brainstewdev/ir-tracker/descrizione.md

IR tracker

Autore: Lorenzo Lucca

Descrizione:
il progetto mira alla creazione di un sistema che permetta ad una webcam/microfono di tracciare un oggetto, montandolo sopra ad una base girevole.
per riuscere in questo sono stati utilizzati sensori ed emettitori infrarossi in modo tale che non sia di disturbo per l'ambiente non essendo visibili. 
l'hardware coinvolto è:

- arduino uno
- servomotore
- 6 fototransistor IR
- 1 LED IR
- alimentatore e regolatore di tensione

per la parte software invece si basa sul trovare il sensore con la minima lettura (quello quindi che punta maggiormente verso la sorgente) e girare la base verso quel sensore, in modo da centrarlo.

Link a repo: https://github.com/brainstewdev/ir-tracker

Licenza scelta: GNU General Public License v3

Data *indicativa* di presentazione: novembre 2024
