brainstewdev/ir-tracker/ir-tracker/ir-tracker.ino

#include<Servo.h>

#define SERVO_PIN 3


/*
    documentazione generale

    per collgare i phototransistor si va a collegare il catodo con il - e l'anodo al + con 
    un a resistenza di 10kohm

    all'interno dell'array pins verrano inseriti i pin a cui sono collegati i phototransistor, 
    da sinistra verso destra.

    all'inizio il servo sarà centrato, saranno impostati i pin in input e poi inizializza la comunicazione seriale
*/

  
Servo servo;

int pos = 90; // posizione del servo, di partenza centrata

int pinS[] = {A0, A1, A2, A3, A4, A5};

int lett[] = {0, 0, 0,0,0, 0};

void setup(){
    /*
        - imposta i pin
        - imposta il servo
        - inizializza serial per debug
    */
    for(int i = 0; i < 6; i++){
        pinMode(pinS[i], INPUT);
    }

   servo.attach(SERVO_PIN);
   servo.write(pos);

   Serial.begin(9600);
}

void loop(){
    // legge i valori dei sensori
     for(int i = 0; i < 6; i++){
        lett[i] = analogRead(pinS[i]);
        
        Serial.print("{");
        Serial.print(i);
        Serial.print(":");
        Serial.print(lett[i]);
        Serial.print("}");
        
    }
    int off = calcolaOffset(lett[0], lett[1], lett[2], lett[3], lett[4], lett[5]);
    servo.write(pos + off);   
    pos = servo.read();
    delay(15);
}

/*
    funzione che date le letture dei sensori calcola l'offset
*/
int calcolaOffset(int x1, int x2, int x3, int x4, int x5, int x6){
    // dove sto puntando sarà il minimo: mi sposto verso chi ha una lettura minore
    int arrLetture[] = {x1,x2,x3,x4,x5,x6};
    int sensMin = posMin(arrLetture, 6);
    // se esiste un sensore con lettura minima
    if(sensMin > -1){
    // se la differenza tra le letture è maggiore della soglia allora:
      if(diffMax(arrLetture,6) > 200){
        // restituisi un offset che varia da 10 a -10
        return map(sensMin, 0, 5, 10,-10);
      }
    }
    // restituisci un offset nullo (sta fermo)
    return 0;
}
// restituisce la massima differenza tra un sensore e uno adiacente
int diffMax(int *arr, int dim){
  int max = -1;
  int diffSx,diffDx;
  for(int i = 1; i < dim-1; i++){
    diffSx = (arr[i-1]-arr[i])*(arr[i-1]-arr[i]);
    diffDx = (arr[i]-arr[i+1])*(arr[i]-arr[i+1]);
    if(diffSx > max){
      max = diffSx;
    }else if(diffDx > max){
      max = diffDx;
    }
  }
  return max;
}
// funzione che dato un array ne calcola la posizione contenente il valore minore
int posMin(int *arr, int dim){
  int min = 1023;
  int pos = -1;
  for(int i = 0; i < dim; i++){
    if(arr[i] < min){
      min = arr[i];
      pos = i;
    }
  }
  return pos;
}
/*
    funzione che data una posizione (globale) e un offset restituisce il valore che:
        - è posizione + offset se <= 180 e >= 0
        - 180 se posizione + offset > 180
        - 0 se posizione + offset < 0
*/
int ottieniPos(int offset){
    if(pos + offset < 0){
        return 0;
    }else if(pos + offset > 180){
        return 180;
    }
    return pos + offset;
}
