brainstewdev/ir-tracker/(commit log)

2024-03-03 funziona di base ma problemi
    infatti va tutto a sinistra se non riceve alcun segnale invece di stare
    fermo oppure fare "radar". inoltre una volta che centra più o meno
    inizia a fare avanti e indietro in un raggio molto piccolo
2024-03-03 aggiunta minimo di doc
2024-03-03 updatata la struttura del progetto
2024-09-25 aggiornato
    aggiornato sketch per supportare la nuova versione dell'hardware.
    ora ci sono 6 sensori piuttosto che 5 e messi in posizioni differenti.
    nuovo approccio per calcolare l'offset, ora si basa sul sensore
    che ha la lettura minima
